dadebertolino/wind-tracker/hardware/sonda/sonda.kicad_sch

## KiCad design hardware/sonda/sonda.kicad_sch (2026-10-27)

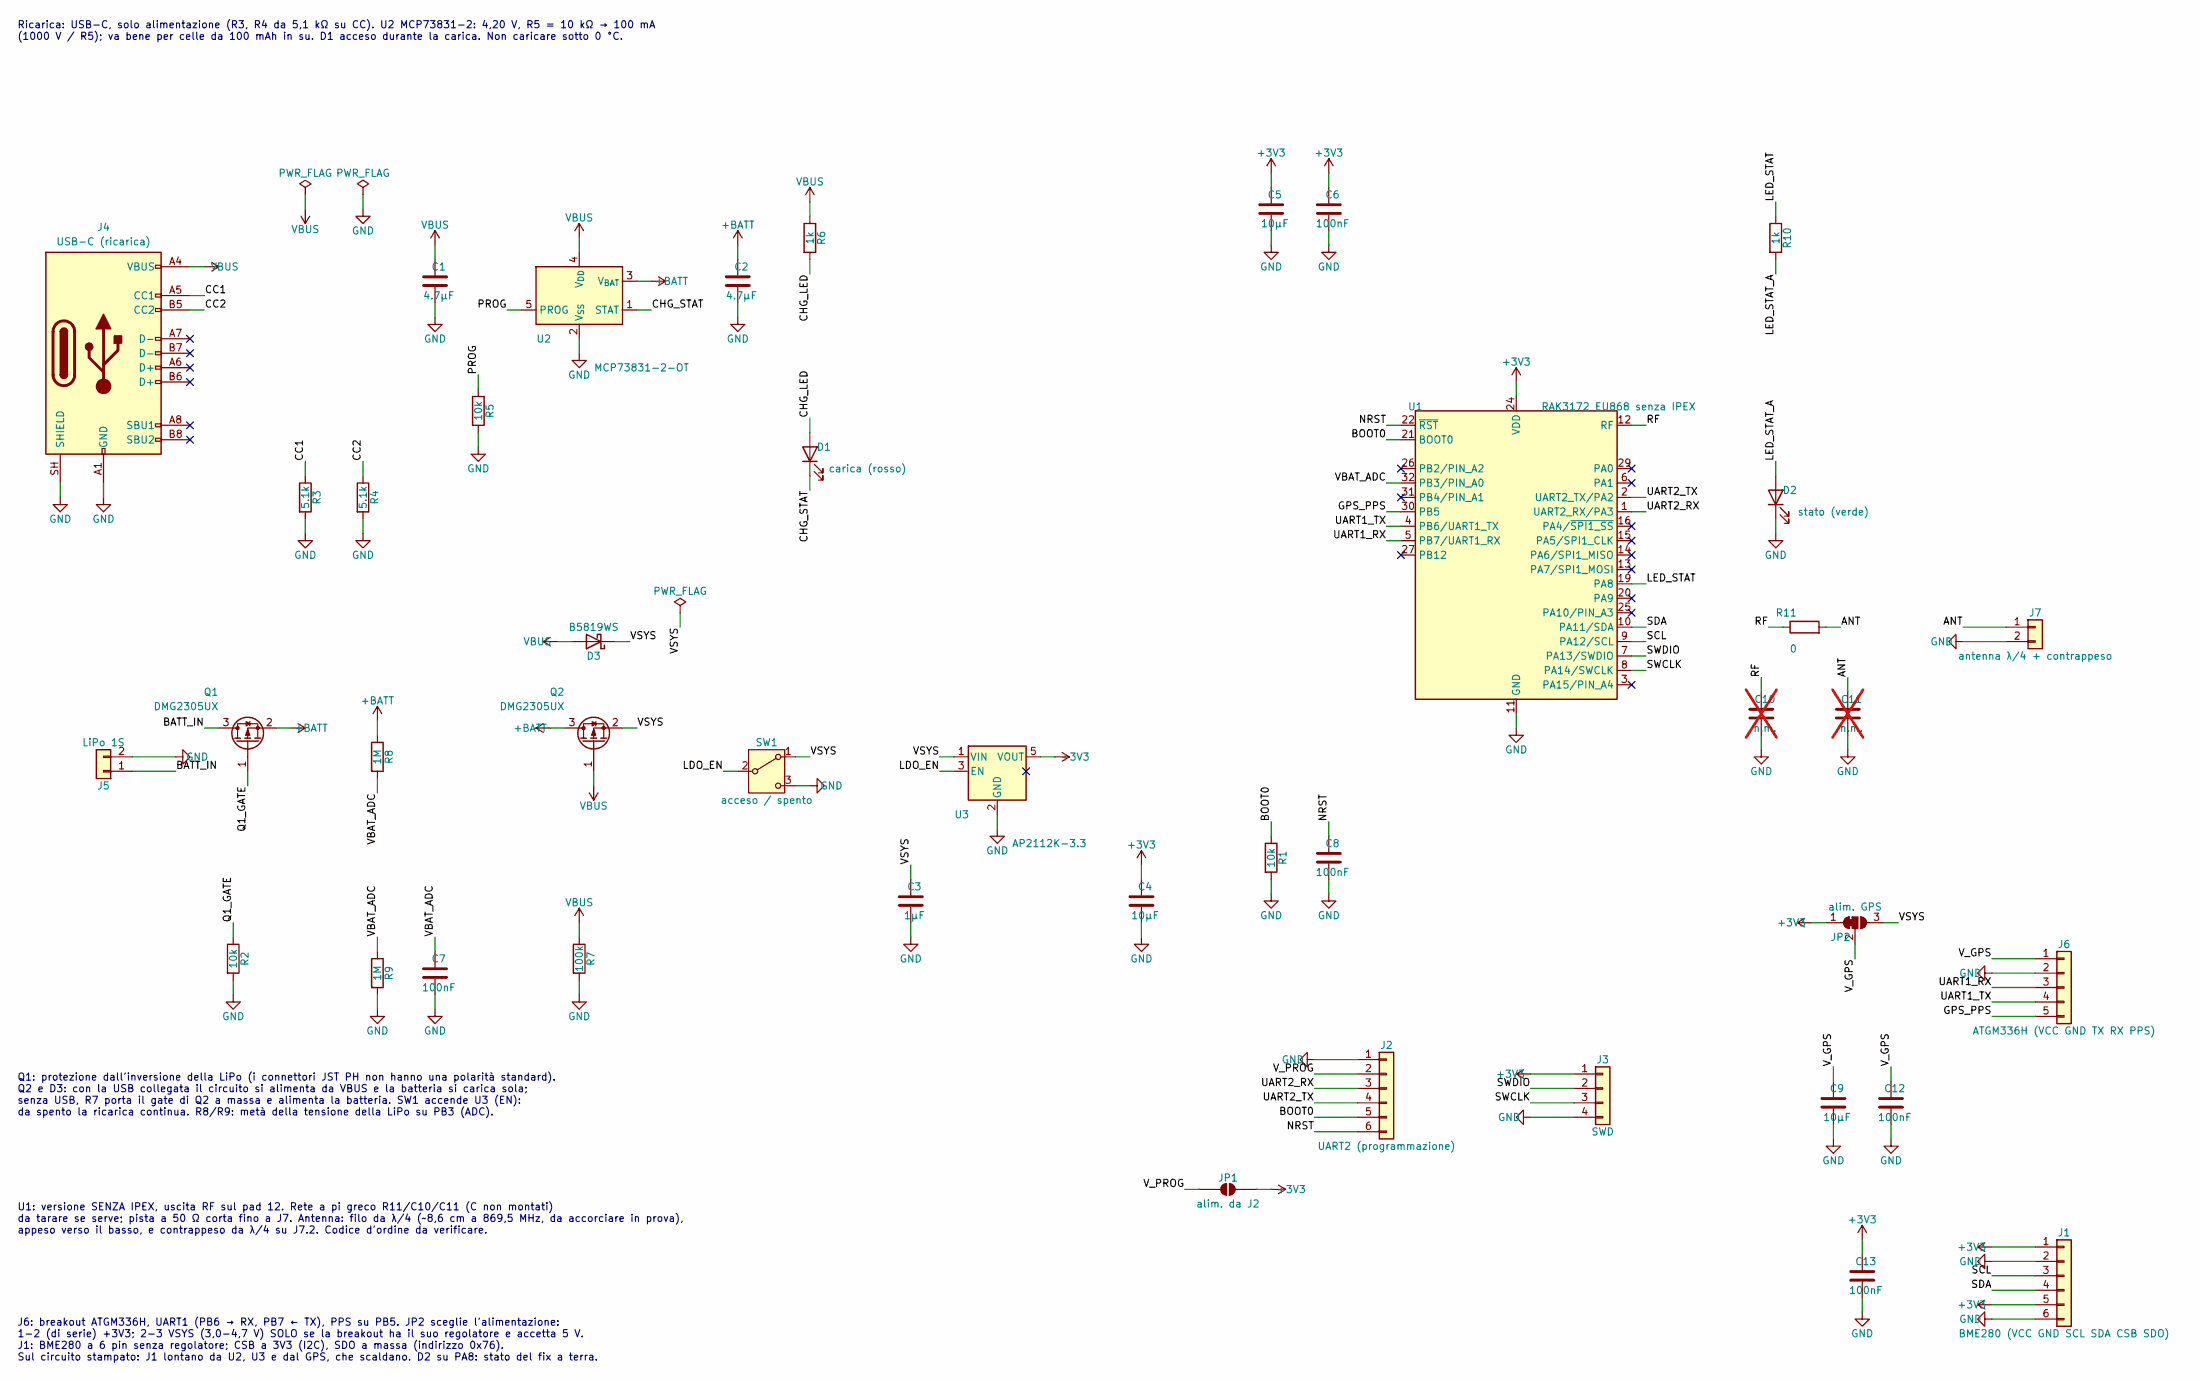
[picture p2: schematic sonda.kicad_sch]

Parts:
C1, C2: 4.7µF; C_0805_2012Metric_Pad1.18x1.45mm_HandSolder
C3: 1µF; C_0805_2012Metric_Pad1.18x1.45mm_HandSolder
C4, C5, C9: 10µF; C_0805_2012Metric_Pad1.18x1.45mm_HandSolder
C6, C7, C8, C12, C13: 100nF; C_0805_2012Metric_Pad1.18x1.45mm_HandSolder
C10, C11: n.m.; C_0805_2012Metric_Pad1.18x1.45mm_HandSolder; not fitted
D1: carica (rosso); LED_0805_2012Metric_Pad1.15x1.40mm_HandSolder
D2: stato (verde); LED_0805_2012Metric_Pad1.15x1.40mm_HandSolder
D3: B5819WS; D_SOD-323_HandSoldering
J1: BME280 (VCC GND SCL SDA CSB SDO); PinHeader_1x06_P2.54mm_Vertical
J2: UART2 (programmazione); PinHeader_1x06_P2.54mm_Vertical
J3: SWD; PinHeader_1x04_P2.54mm_Vertical
J4: USB-C (ricarica); USB_C_Receptacle_HRO_TYPE-C-31-M-12
J5: LiPo 1S; JST_PH_S2B-PH-SM4-TB_1x02-1MP_P2.00mm_Horizontal
J6: ATGM336H (VCC GND TX RX PPS); PinHeader_1x05_P2.54mm_Vertical
J7: antenna λ/4 + contrappeso; PinHeader_1x02_P2.54mm_Vertical
JP1: alim. da J2; SolderJumper-2_P1.3mm_Open_RoundedPad1.0x1.5mm
JP2: alim. GPS; SolderJumper-3_P1.3mm_Bridged12_RoundedPad1.0x1.5mm
Q1, Q2: DMG2305UX; SOT-23_Handsoldering
R1, R2, R5: 10k; R_0805_2012Metric_Pad1.20x1.40mm_HandSolder
R3, R4: 5.1k; R_0805_2012Metric_Pad1.20x1.40mm_HandSolder
R6, R10: 1k; R_0805_2012Metric_Pad1.20x1.40mm_HandSolder
R7: 100k; R_0805_2012Metric_Pad1.20x1.40mm_HandSolder
R8, R9: 1M; R_0805_2012Metric_Pad1.20x1.40mm_HandSolder
R11: 0; R_0805_2012Metric_Pad1.20x1.40mm_HandSolder
SW1: acceso / spento; SW_SPDT_PCM12
U1: RAK3172 EU868 senza IPEX; RAK3172
U2: MCP73831-2-OT; SOT-23-5
U3: AP2112K-3.3; SOT-23-5

Connections:
+3V3: C4.1, C5.1, C6.1, C13.1, J1.1, J1.5, J3.1, JP1.2 (B), JP2.1 (A), U1.24 (VDD), U3.5 (VOUT)
+BATT: C2.1, Q1.2 (S), Q2.3 (D), R8.1, U2.3 (V_{BAT})
ANT: C11.1, J7.1, R11.2
BATT_IN: J5.1, Q1.3 (D)
BOOT0: J2.5, R1.1, U1.21 (BOOT0)
CC1: J4.A5 (CC1), R3.1
CC2: J4.B5 (CC2), R4.1
CHG_LED: D1.2 (A), R6.2
CHG_STAT: D1.1 (K), U2.1 (STAT)
GND: C1.2, C2.2, C3.2, C4.2, C5.2, C6.2, C7.2, C8.2, C9.2, C10.2, C11.2, C12.2, C13.2, D2.1 (K), J1.2, J1.6, J2.1, J3.4, J4.A1 (GND), J4.A12 (GND), J4.B1 (GND), J4.B12 (GND), J4.SH (SHIELD), J5.2, J6.2, J7.2, R1.2, R2.2, R3.2, R4.2, R5.2, R7.2, R9.2, SW1.3 (C), U1.11 (GND), U1.17 (GND), U1.18 (GND), U1.23 (GND), U1.28 (GND), U2.2 (V_{SS}), U3.2 (GND)
GPS_PPS: J6.5, U1.30 (PB5)
LDO_EN: SW1.2 (B), U3.3 (EN)
LED_STAT: R10.1, U1.19 (PA8)
LED_STAT_A: D2.2 (A), R10.2
NRST: C8.1, J2.6, U1.22 (~RST)
PROG: R5.1, U2.5 (PROG)
Q1_GATE: Q1.1 (G), R2.1
RF: C10.1, R11.1, U1.12 (RF)
SCL: J1.3, U1.9 (PA12/SCL)
SDA: J1.4, U1.10 (PA11/SDA)
SWCLK: J3.3, U1.8 (PA14/SWCLK)
SWDIO: J3.2, U1.7 (PA13/SWDIO)
UART1_RX: J6.3, U1.5 (PB7/UART1_RX)
UART1_TX: J6.4, U1.4 (PB6/UART1_TX)
UART2_RX: J2.3, U1.1 (UART2_RX/PA3)
UART2_TX: J2.4, U1.2 (UART2_TX/PA2)
VBAT_ADC: C7.1, R8.2, R9.1, U1.32 (PB3/PIN_A0)
VBUS: C1.1, D3.2 (A), J4.A4 (VBUS), J4.A9 (VBUS), J4.B4 (VBUS), J4.B9 (VBUS), Q2.1 (G), R6.1, R7.1, U2.4 (V_{DD})
VSYS: C3.1, D3.1 (K), JP2.3 (B), Q2.2 (S), SW1.1 (A), U3.1 (VIN)
V_GPS: C9.1, C12.1, J6.1, JP2.2 (C)
V_PROG: J2.2, JP1.1 (A)

Notes on the sheet:
Ricarica: USB-C, solo alimentazione (R3, R4 da 5,1 kΩ su CC). U2 MCP73831-2: 4,20 V, R5 = 10 kΩ → 100 mA (1000 V / R5); va bene per celle da 100 mAh in su. D1 acceso durante la carica. Non caricare sotto 0 °C.
Q1: protezione dall'inversione della LiPo (i connettori JST PH non hanno una polarità standard). Q2 e D3: con la USB collegata il circuito si alimenta da VBUS e la batteria si carica sola; senza USB, R7 porta il gate di Q2 a massa e alimenta la batteria. SW1 accende U3 (EN): da spento la ricarica c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
U1: versione SENZA IPEX, uscita RF sul pad 12. Rete a pi greco R11/C10/C11 (C non montati) da tarare se serve; pista a 50 Ω corta fino a J7. Antenna: filo da λ/4 (~8,6 cm a 869,5 MHz, da accorciare in prova), appeso verso il basso, e contrappeso da λ/4 su J7.2. Codice d'ordine da verificare.
J6: breakout ATGM336H, UART1 (PB6 → RX, PB7 ← TX), PPS su PB5. JP2 sceglie l'alimentazione: 1-2 (di serie) +3V3; 2-3 VSYS (3,0-4,7 V) SOLO se la breakout ha il suo regolatore e accetta 5 V. J1: BME280 a 6 pin senza regolatore; CSB a 3V3 (I2C), SDO a massa (indirizzo 0x76). Sul circuito stampato: J1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
