dadebertolino/wind-tracker/(commit log)

2026-10-27 Hardware: schemi 0.1 della sonda e della base station
    Sonda per pallone pilota: RAK3172 senza IPEX con antenna a filo,
    breakout ATGM336H su UART1, BME280 in I2C, LiPo 1S con ricarica
    MCP73831 da USB-C, commutazione USB/batteria, AP2112K-3.3, partitore
    per la tensione della LiPo. ERC senza errori.
    Base station: copia del ricevitore USB di stazione-meteo-lora,
    stessa netlist.
    [base.kicad_sch, sonda.kicad_sch]
2026-10-27 Firmware 0.1 di sonda e base station, prove al banco
    Sonda: GPS ATGM336H su UART1 con parser NMEA (GGA, RMC) senza librerie,
    trasmissione alla prima epoca completa dopo l'intervallo (2 s ± 10 %),
    869,525 MHz SF8 20 dBm con controllo del duty cycle in compilazione,
    pacchetto v1 da 32 byte con CRC-16, BME280, tensione della LiPo dal
    partitore su PB3, LED di stato del fix, autodiagnosi e watchdog.
    Base station: fork del ricevitore della stazione meteo con i nuovi
    parametri radio, decodifica in CSV, segnalazione di fix acquisito o
    perso, LED a ogni pacchetto.
    test_banco: 33 prove sul PC di parser NMEA, pacchetto e decodifica.
    [base.ino, sonda.ino]
